evortriede/PumpController/hardware/PumpControllerBOM.md

#Pump Controller Bill of Materials

- ESP32 Development Board [ESP32 Dev Board](https://smile.amazon.com/gp/product/B0718T232Z)
- MCP4725 Breakout Board [MCP4725 Breakout Board](https://smile.amazon.com/dp/B00SK8MBXI)
- Current to Voltage Converter [4-20mA - V Converter](https://smile.amazon.com/gp/product/B07MYXVDDX)
- Male DB9 Connector [DB9 Plug](https://smile.amazon.com/dp/B07Z535JD7)
- Shop Materials On Hand
  - Stripe board
  - 2.2uF Capacitor
  - In-line connectors
  - Barrel Jack (4-20mA input from CL17)
  - Wire
  - Solder
