evortriede/PumpController/(list of files, drawings)

Other design files:
hardware/PumpController.dsn
hardware/PumpController_pulse.dsn
