evortriede/PumpController/(commit log)

2023-02-08 DAC and Doc mods
    Modified sketch to use MCP4725 DAC (compile time option)
    Added hardware CAD & BOM
    Made a start on the README
    [PumpController.dsn]
2023-02-14 Fixed config bug
    Config was saving adjust frequency as auto start setting.
    [PumpController.ino]
2023-05-12 Added support for LMI PD7xx pump
    [PumpController_pulse.dsn]
2024-07-20 Restrict max to configured value
    When the pump speed is set, if greater than the configured maximum, set it to the configured maximum.
2024-07-24 Convert to new ESP APIs
    Moved to a new computer which required updating boards and libraries. Timer and ADC APIs had changed requiring new approaches.
2025-09-24 Added API
    /startPump starts pump in auto mode
    /stopPump stops the pump
